Coral-Chamber/Coral-Chamber-Engi-200/README.md

# Coral-Chamber-Engi-200
Coral Chamber Project Code, CAD files, manufacturing guides, and Tutorial

For Coral Chamber Project, ENGI 200 Rice University
