Coral-Chamber/Coral-Chamber-Engi-200/CAD/README.md

This folder contains CAD files for the coral flow chamber device designed in ENGI 200 @RiceUniversity.
