Coral-Chamber/Coral-Chamber-Engi-200/Electronics/CC_schematic_final_schem.jpg

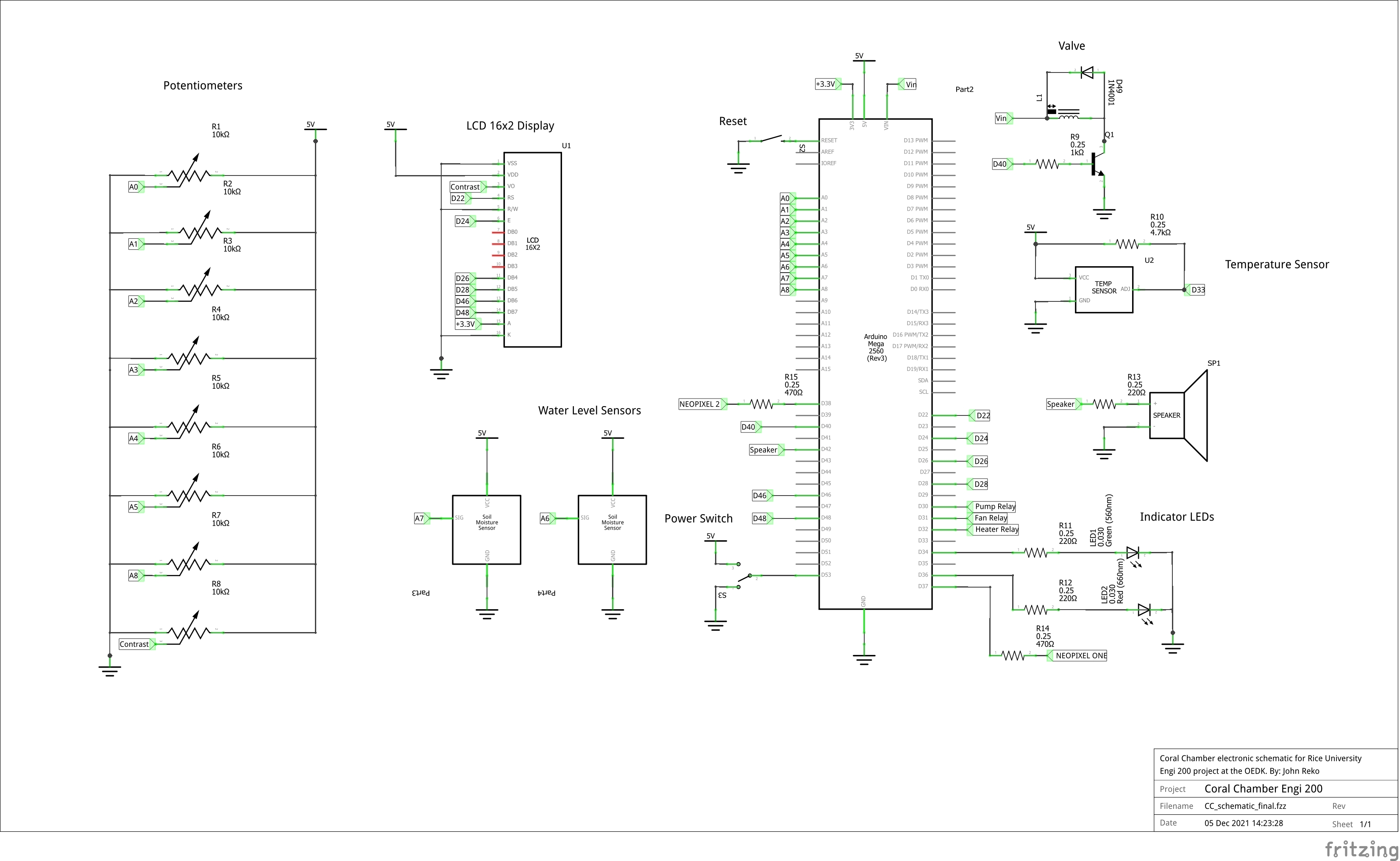
Electronics/CC_schematic_final_schem.jpg
