Coral-Chamber/Coral-Chamber-Engi-200/CAD/SealMold.STL

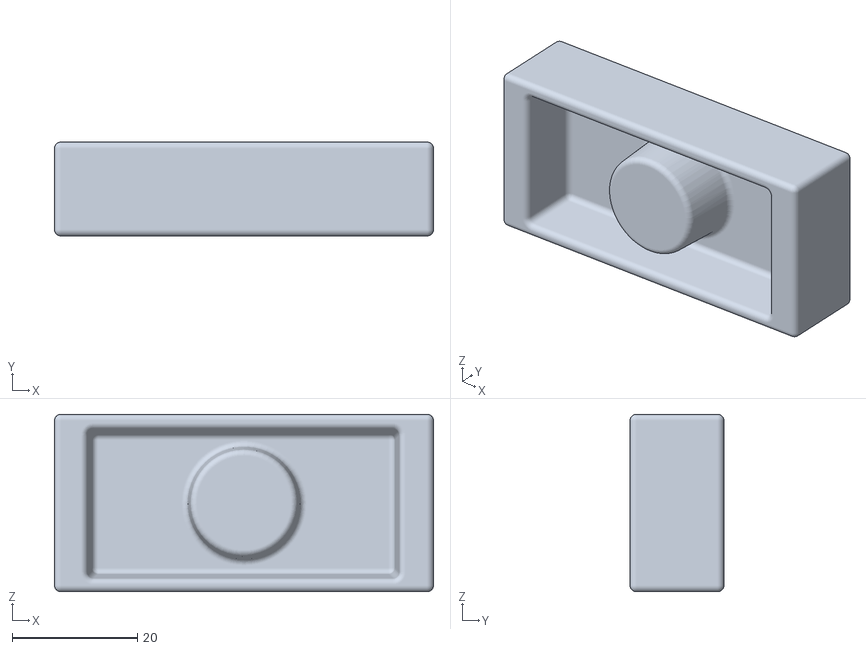
[picture p2: CAD file, 2021-12-10]
CAD/SealMold.STL
60.6 x 15.0 x 28.4
