Coral-Chamber/Coral-Chamber-Engi-200/CAD/light clamp.SLDPRT

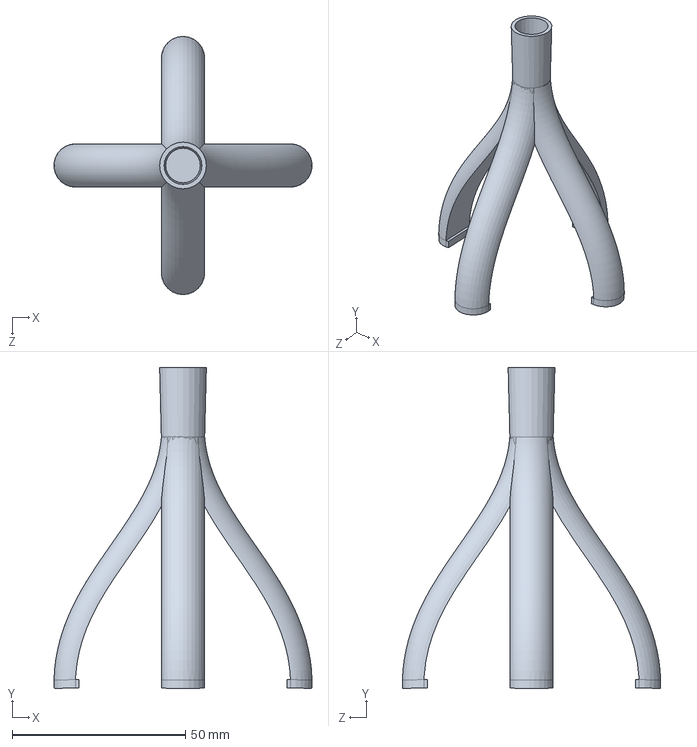
[picture p3: CAD file, 2021-12-10]
CAD/light clamp.SLDPRT
74.4 x 92.6 x 74.5 mm
