Coral-Chamber/Coral-Chamber-Engi-200/CAD/Baseplate2.21.STL

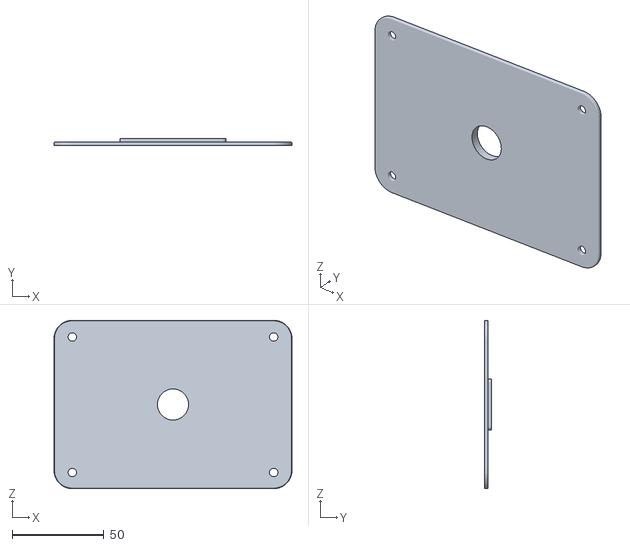
[picture p4: CAD file, 2021-12-10]
CAD/Baseplate2.21.STL
130.0 x 4.00 x 92.0
