Coral-Chamber/Coral-Chamber-Engi-200/CAD/light clampv2.STL

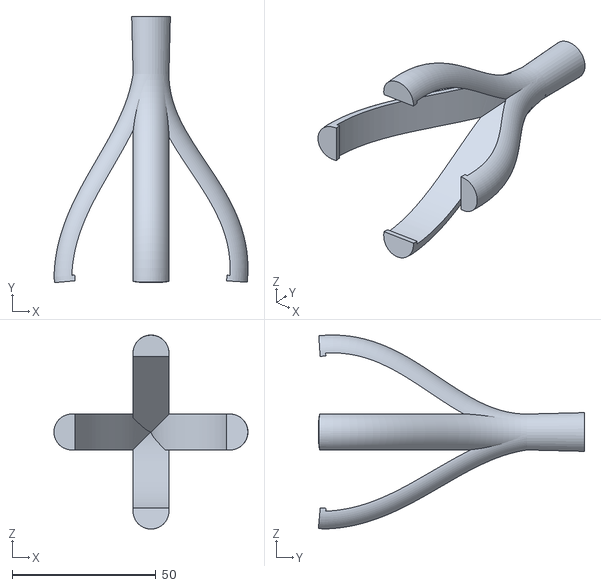
[picture p5: CAD file, 2021-12-10]
CAD/light clampv2.STL
67.4 x 92.5 x 67.4
