Coral-Chamber/Coral-Chamber-Engi-200/(list of files, cad)

Other CAD files:
CAD/Baseplate2.2.SLDPRT
CAD/light clamp.STL
